Emilien-Wolff/Minuto/README.md

# Minuto - mission technique de l'ingénieur ⚙️
> [!NOTE]
> Un projet dans le cadre de ma première année en école d'ingénieur visant la fabrication d'un capteur d'irradiance solaire

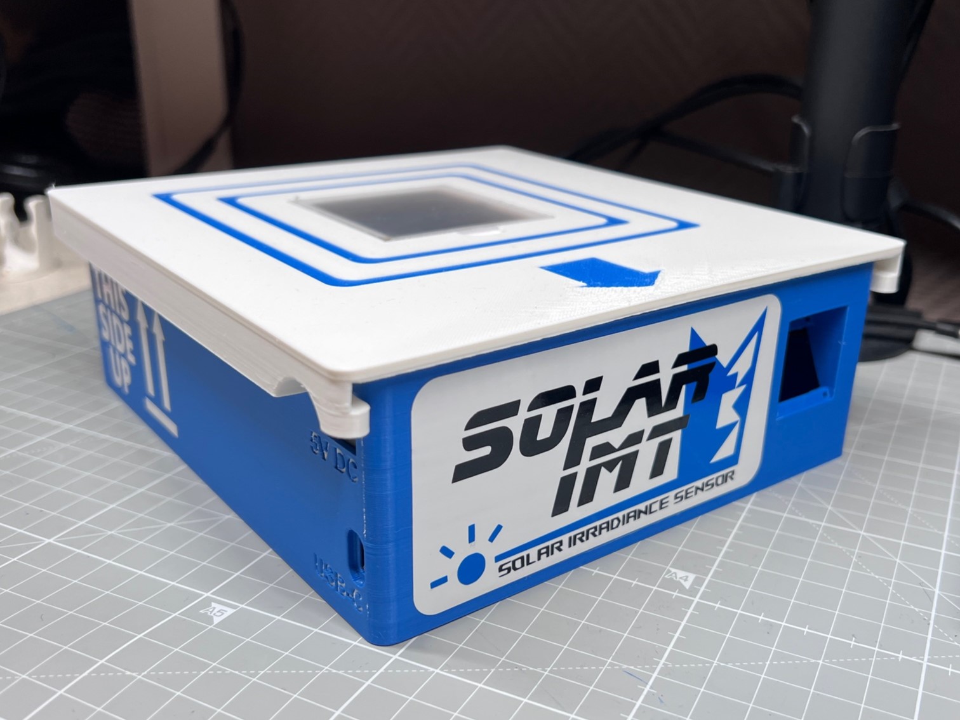
[picture p1: Photos/IMG_6275.JPG]


## Mon objectif

> Conceptualiser, dimensionner et créer un capteur fonctionnel d'irradiance solaire

## Points abordés

 - Gestion de projet : diagramme de Gantt, partage des tâches et planification
 - Étude des phénomènes conducto-convectifs et négligeabilité de ceux-ci
 - Montage en pont de Wheatstone amplifié sur thermistance
 - Étalonnage de cette dernière en enceinte adiabatique
 - Programmation du micro contrôleur Arduino R4
 - Apprentissage du pistage en CAO et fabrication sur mesure d’un PCB et d’un boîtier imprimé en 3D
 - Tests finaux et incertitudes

## FAQ

#### Pourquoi cette méthode de mesure ?
"Minuto" était une unité d'enseignement qui fait totalement partie de ma formation d'ingénieur et l'objectif était de faire un premier pas dans la gestion de projet. La mesure exploitant la capacité thermique massique du bloc de laiton était un moyen d'appliquer des montages électroniques de base et de discuter sur la précision de mesure. 

#### Combien de temps ça t'as pris ?

Le projet a duré 4 mois, d'octobre 2024 à janvier 2025

#### T'as fait ça tout seul ??

Pas du tout ! J'ai eu l'occasion de travailler avec des camarades de mon école, et ce fut extrêmement enrichissant de collaborer avec eux. Merci Anatole, Camille, Salah, Isma et LP !

## 🚀 Qui suis-je ?
Je suis actuellement en première année d'école d'ingénieur à l'école des Mines IMT Atlantique. Je voudrais continuer mon cursus dans l'électronique et les sytèmes embarqués
