Emilien-Wolff/Minuto/PCB/Readme.md

# PCB Minuto

Partie PCB du projet ! Ce dossier contient les fichiers nécessaires à la fabrication et à l'assemblage de la carte PCB du Minuto.

## Fichiers Inclus

- **Fichiers Gerber (.gbr) :** Utilisés pour la fabrication de la PCB. Envoyez-les à votre service de fabrication de PCB.
- **Liste des composants (BOM) (.csv) :** Liste complète des composants utilisés dans le design, avec les quantités et les numéros de pièces.
- **Schéma et Design PCB (.json) :** Métadonnées du design au format JSON, compatibles avec Easy EDA.
- **Faces du pcb (.pdf) :** deux faces de la PCB et schéma électrique global
- **Fichiers supplémentaires (.zip) :** Contient des modèles 3D, des informations sur les couches du PCB et des scripts de test.

## Licence

Ce projet est libre d'accès
