Emilien-Wolff/Minuto/Code_arduino/Readme.md

# Code - Capteur d'Irradiance Solaire  

Ce dossier contient :  
- **`tracé courbes.py`** : Script Python pour tracer les courbes d'étalonnage du capteur en relevant les couples **tension - température**. Il faut téléverser le fichier  **`etalonnage_final.ino`** dans l'Arduino avant.
- **`CapteurTempAvecEcranTempo_V7.ino`** : Code Arduino calculant et affichant l'irradiance solaire sur un écran **OLED 128x64** sur une durée **Δt** modifiable dans le code.  

## Utilisation  

- **Étalonnage (Python)** :  
  ```sh
  pip install matplotlib numpy  
  ```  
- **Mesure (Arduino)** :  
  1. Ouvrir `CapteurTempAvecEcranTempo_V7.ino` dans l'IDE Arduino.  
  2. Modifier $\Delta t$ si nécessaire.  
  3. Téléverser le code sur un **Arduino R4 Wifi**.  

📌 *Vérifiez les connexions du capteur et de l'afficheur OLED avant exécution. Attention aux faux contacts sur breadboard, c'est pour ça qu'on a décidé de faire un pcb ...*
