Emilien-Wolff/Minuto/Modele_3D/Readme.md

# Boîtier Minuto - Fichiers Fusion 360 & STEP

Ce dossier contient les fichiers de conception du boîtier Minuto, réalisés avec Fusion 360.

## Contenu du dossier

- **Fichiers `.f3z`** : Assemblages natifs de Fusion 360, permettant de modifier les composants individuellement.
- **Fichiers `.step`** : Modèles exportés en STEP, compatibles avec d'autres logiciels de CAO.

## Utilisation

- **Fusion 360** : Importez les fichiers `.f3z` pour modifier les composants du boîtier.
- **Autres logiciels CAO** : Utilisez les fichiers `.step` pour une compatibilité universelle.

📁 *Assurez-vous d'extraire tous les fichiers associés avant d'ouvrir un assemblage dans Fusion 360.*

---

Impression 3D en PLA sur P1S, 0,2mm d'épaisseur de couche, avec supports, attention à bien choisir la couleur du couvercle supérieur
