Emilien-Wolff/Minuto/Quatre_quadrants/Suivi_GroupeB11_05nov.pdf

# Reporting Quatre Quadrants n°3

## Projet Minuto - FISE A1

## Groupe B11

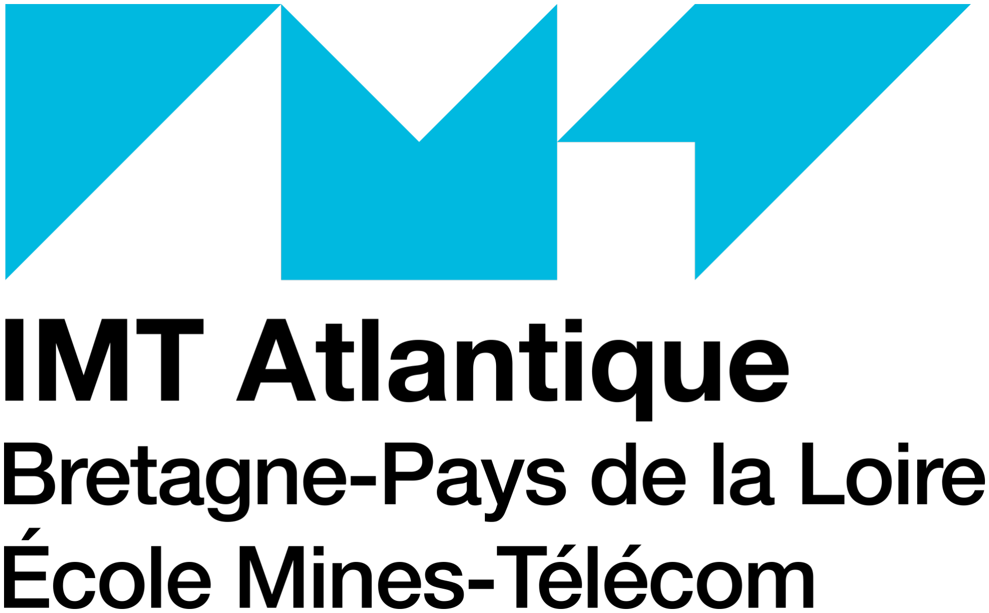
[picture p2: figure]

5 novembre 2024

Minuto - IMT Atlantique

Consitution de l’équipe
Groupe/Equipe : B11
Chef de projet : Emilien WOLFF

Actualisation de la fiche à la date du : 05/11

▷ Ce que nous avions prévu de faire aujourd’hui

- Mesure de cT à l’aide de la relation :

claiton =

E

mlaiton × ∆T

=

(V × I) × ∆t

mlaiton × (Tf − Ti)
- Suivi du projet dans GanttProject
- Continuer le compte-rendu final sur Overleaf
- Etalonnage du ´ | pont de Wheatstone
- Quantifier les échanges conducto-convectifs non pris en compte dans la relation

Firrad =

m · cT · ∆T
∆t · S
- Comparaison de la précision du pont de Wheatstone et du montage avec le pont diviseur de tension
- Bonus : Utilisation d’un afficheur OLED pour avoir la température en temps réel et actualisation de l’affichage

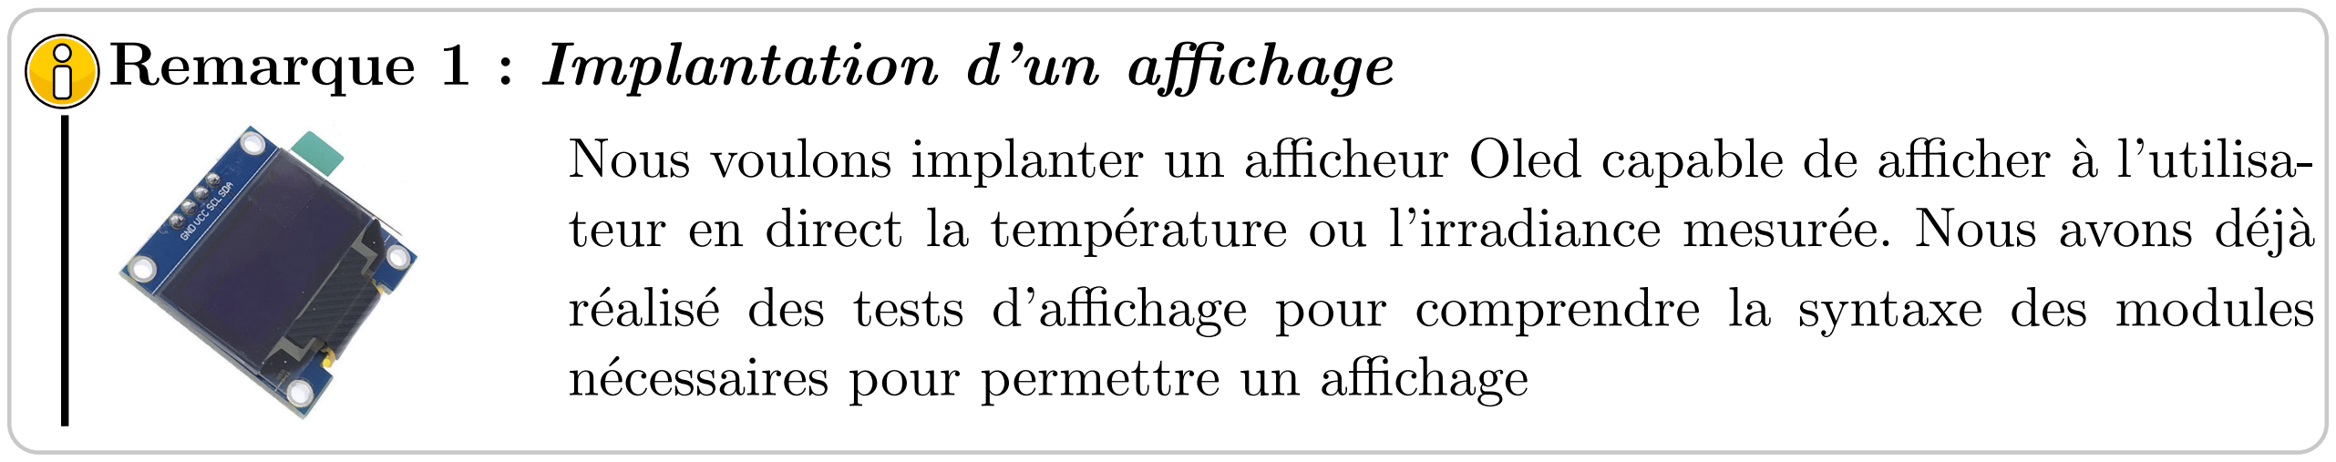
[picture p3: figure]
nécessaires pour permettre un affichage

Nous voulons implanter un afficheur Oled capable de afficher à l’utilisa-teur en direct la température ou l’irradiance mesurée. Nous avons déjà réalisé des tests d’affichage pour comprendre la syntaxe des modules

Remarque 1 : Implantation d’un affichage

▷ Ce que nous avons réalisé effectivement

- Etalonnage du ´ | pont de Wheatstone
- Suivi du projet dans GanttProject
- Continuer le compte-rendu final sur Overleaf
- Pour mesurer la capacité calorifique cT nous avons :

— Mesuré l’intensité i à l’aide de la loi d’Ohm : I = 510mA
— Mesuré la masse m de laiton : m = 622g
— Choisi un ∆t = 600 s pendant lesquelles nous avons mesuré un ∆T = 3,77 K
- On trouve finalement : cT = 646 J·K⁻¹
- kg⁻¹

▷ Ce que nous prévoyons de faire les prochains jours

- Refaire la mesure de cT en réduisant la longueur du fil
- Implémentation de l’affichage OLED
- Calcul de la capacité thermique massique avec la nouvelle longueur de fil
- Modélisation d’un boitier pour intégrer le LCD et impression
- Première campagne de mesure

1

Minuto - IMT Atlantique

▷ Problèmes rencontrés et solutions mises en œuvre

- Fil NICr vert trop long pour entrer entièrement dans la cavité de laiton. Nous prévoyons donc de réduire la longeur du fil pour résoudre ce problème
- Pour la première version du code en annexe, l’alimentation du DDT était de 3,3V et pas de 5V. Les valeurs étaient abérantes.

## Annexes : codes de la session

Mesure de la capacité cT à partir des coefficients de la courbe de la session précédente (coeff directeur et ordonnées à l’origine)

1 | // P a r a m t r e s du diviseur de tension
2 | const int analogPin = A0; | // Broche analogique pour lire la tension
3 | const float Vcc = 3.3; | // Tension d’ alimentation du diviseur de
| tension (par exemple 5V)

4
5 | // Coefficients du m o d l e | l i n a i r e
6 | const float a = -0.0188219999851621; | // Coefficient de la pente
7 | const float b = 1.5478256877795376; | // Coefficient de l’ o r d o n n e | l
| ’origine

8
9 | void setup () {
10 | Serial . begin (115200) ; | // Initialisation de la communication s r i e
11 | }

12
13 | void loop () {
14 | int adcValue = analogRead ( analogPin ) ; | // Lecture de la tension
| analogique
15 | float U = ( adcValue / 1023.0) * Vcc; | // Conversion de la
| lecture ADC en tension

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

19
20 | // Affichage des r s u l t a t s dans le moniteur s r i e
21 | Serial . print (" Tension (V): ") ;
22 | Serial . print (U) ;
23 | Serial . print (" | T e m p r a t u r e ( C ): ") ;
24 | Serial . println ( temperature ) ;

25
26 | delay (1000) ; | // Attente avant la prochaine mesure
27 | }

Remarques : Le code fonctionne correctement et mesure de températures sont bonnes

2
