Emilien-Wolff/Minuto/Quatre_quadrants/Suivi_GroupeB11_12nov.pdf

# Reporting Quatre Quadrants n°4

# Projet Minuto - FISE A1

## Groupe B11


## 12 novembre 2024

### Minuto - IMT Atlantique

### Consitution de l’équipe Groupe/Equipe : B11 Chef de projet : Emilien WOLFF

### Actualisation de la fiche à la date du : 12/11

## ▷ Ce que nous avions prévu de faire aujourd’hui

### - Mesure de cT à l’aide de la relation :

claiton =

E

mlaiton × ∆T

=

### (V × I) × ∆t

mlaiton × (Tf − Ti)

### Or on remarque que :

∆T
∆t

=

P

### mct

Ce rapport est donc constant et nous allons donc réaliser plusieurs mesures de températures sur des intervalles ∆t = 30 s puis réaliser une régression linéaire.

### - Suivi du projet dans GanttProject

### - Continuer le compte-rendu final sur Overleaf

- Etalonnage du ´ | pont de Wheatstone

### - Quantifier les échanges conducto-convectifs non pris en compte dans la relation

Firrad =

### m · cT · ∆T

∆t · S

### - Comparaison de la précision du pont de Wheatstone et du montage avec le pont diviseur

### de tension - Découpage et détorsadage du fil de NiCr pour qu’il ait les bonnes dimensions et pour

### garder uniquement le fil blanc chauffant

## ▷ Ce que nous avons réalisé effectivement

### - Modélisation du boîtier en 3D à l’aide du logiciel Fusion 360

- Test d’affichage des valeurs de la température et de l’irradiance sur l’écran OLED.

### - Prise de mesures du boîtier

- Découpage et détorsadage du fil de NICr pour qu’il ait les bonnes dimensions de manière

### à garder uniquement le fil blanc chauffant - Pour mesurer la capacité calorifique cT nous avons :

### — Choisi un ∆t = 30 s pendant lesquelles nous avons mesuré un ∆T. Nous avons réalisé cela pendant 11 minutes. Voici le tableau des premières valeurs :

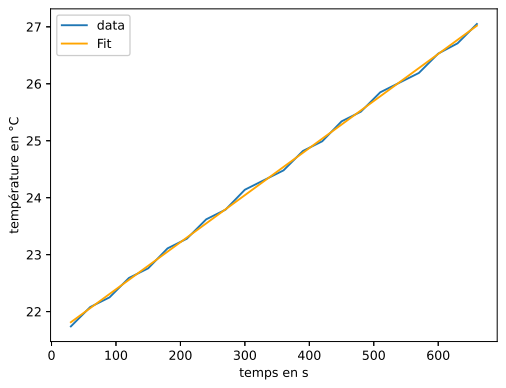
[picture p4: figure]

### Régression linéaire sur les valeurs mesurées

Temps (s) | Température (°C)
0 | 21.91
30 | 21.74
60 | 22.08
90 | 22.25
120 | 22.59
150 | 22.76
180 | 23.11
210 | 23.28
660 | 27.05

### — Mesuré l’intensité i à l’aide de la loi d’Ohm : I = 510mA

### — Mesuré la masse m de laiton : m = 622g

### - On trouve finalement :

## cT = 423 J·K⁻¹

# - kg⁻¹

### - Suivi du projet dans GanttProject

### - Continuer le compte-rendu final sur Overleaf

### - Modélisation 3D du boîtier

## ▷ Ce que nous prévoyons de faire les prochains jours

- Modification des côtes du boîtier et impression 3D (attention à ne pas choisir des couleurs

### sombres)

### - Deuxième campagne de mesures

## ▷ Problèmes rencontrés et solutions mises en œuvre

### - Essai infructueux du pont de Wheatstone (mauvais branchements que nous allons re-

### prendre dans la semaine)

# Annexes : codes de la session

## Code final comprenant l’affichage sur le LCD

1
2 | # include < SPI .h >
3 | # include < Wire .h >
4 | # include < Adafruit_GFX .h > | // for the rectangle draw and text display
5 | # include < Adafruit_SSD1306 .h > | // to control the OLED chip

6

7
8 | int measurement_counter = 0; | // count the number of measurements done ; used for
Serial print

9
10 | // /////////////////////////
11 | // | SCREEN DESCRIPTION
12 | // | _________________
13 | // | | _________________ | | Area YELLOW 128 x 16 pixels (0 to 15)
14 | // | | | |
15 | // | | | | | Area BLUE 128 x 48 (16 to 63)
16 | // | | | |
17 | // | | _________________ |

18
19 | # define SCREEN_WIDTH 128 // OLED display width , in pixels
20 | # define SCREEN_HEIGHT 64 // OLED display height , in pixels
21 | # define SCREEN_BLUE_START 16 // OLED blue area starts here in Y position
22 | // Declaration for an SSD1306 display connected to I2C (SDA , SCL pins )
23 | # define OLED_RESET | -1 // Reset pin # (or -1 if sharing Arduino reset pin).
No reset on the screen module .
24 # define SCREEN_ADDRESS 0 x3C // The address written on the OLED board (0 x78) must be divided by 2 = > 0 x3C

25
26 | // Create the display object connected to I2C bus ( Wire )
27 | Adafruit_SSD1306 display ( SCREEN_WIDTH , SCREEN_HEIGHT , &Wire , OLED_RESET ) ;

29 // //////////////////////////

30
31 | // | FUNCTIONS | //

32
33 // //////////////////////////

34
35 | // ///////////////////////////////////
36 | // | Function : draws a horizontal bar filled for the value given , in proportion
to the max_value given
37 | // | Input : an integer for the value and an integer for the max value ( bar
totally filled ). Negative value not supported
38 | // | Output : none
39 | // ///////////////////////////////////
40 | void draw_value_in_bar ( unsigned long value , unsigned long max_value )
41 | {
42 | if (value > max_value ) value = max_value ; | // avoid to try to draw an
impossible bar.
43 | display . fillRect (0 , 0 , display . width () , SCREEN_BLUE_START -1 , SSD1306_BLACK ) ;
// Draw black rectangle = erase the bar display area
44 | display . drawRect (0 , 0 , display . width () , SCREEN_BLUE_START -1 , SSD1306_WHITE ) ;
// Draw the frame for the full bar ( empty fill )
45 | display . fillRect (0 , 0 , (int ) display . width () * value / max_value ,
SCREEN_BLUE_START -1 , SSD1306_WHITE ) ; // Draw the necessary fill corresponding to the value
46 | display . display () ; | // push to the display
47 | }

48
49 | // ///////////////////////////////////
50 | // | Function : displays a string centered vertically and horizontally in the blue
part of the screen
51 | // | Input : a text in the STRING type
52 | // | Output : none
53 | // ///////////////////////////////////
54 | void draw_string_centered ( String text )
55 | {
56 | Serial . print (" Measurement ") ;
57 | Serial . print ( measurement_counter ) ;
58 | Serial . print (" : ") ;
59 | Serial . println ( text ) ;

60
61 | // Text dimensions calculation
62 | int16_t x1 , y1;
63 | uint16_t textWidth , textHeight ;
64 | display . setTextSize (3) ; | // Normal : 1 | Use 3X normal
size
65 | display . setTextColor ( SSD1306_WHITE ) ; | // Draw white text

66
67 | display . getTextBounds (text , 0 , 16 , &x1 , &y1 , & textWidth , & textHeight ) ;
68 | // Erase the display area with black rectangle
69 | display . fillRect (0 , 16 , display . width () , display . height () , SSD1306_BLACK ) ;
70 | // compute the text cursor position to get it centered
71 | int16_t xPos = ( display . width () - textWidth ) / 2;
72 | int16_t yPos = ( (( display . height () - SCREEN_BLUE_START - textHeight ) / 2) +
SCREEN_BLUE_START ) ;
73 | display . setCursor (xPos , yPos ) ;
74 | display . print ( text ) ;
75 | display . display () ;
76 | }

77
78 | // ADC characteristics
79 | # define MAX_VOLTAGE_ADC 4.6 | // the real voltage used by the ADC on the arduino
board
80 | # define ADC_STEPS 1024 | // Number of steps of the conversion : 10 bits
81 | // Declaration of the coefficient for the function approaching the thermistance
voltage with resistive voltage divider
82 # define THERM_DIV_COEFF_A0 1 // for constant part

83 | # define THERM_DIV_COEFF_A1 1 // for linear part
84 | # define THERM_DIV_COEFF_A2 1 // for square part
85 | # define THERM_DIV_COEFF_A3 1 // for cubic part

86
87 | // ///////////////////////////////////
88 | // | Function : gives the temperature corresponding the the ADC value , using the
thermistance curve
89 | // | Input : the ADC value , and int
90 | // | Output : the temperature as a float
91 | // ///////////////////////////////////
92 | float calculate_temperature (int adc_value )
93 | {
94 | float voltage , temperature ;
95 | voltage = MAX_VOLTAGE_ADC * adc_value / ADC_STEPS ;
96 | temperature = THERM_DIV_COEFF_A0 + THERM_DIV_COEFF_A1 * voltage +
THERM_DIV_COEFF_A2 *pow( voltage ,2) + THERM_DIV_COEFF_A3 *pow( voltage ,3) ;
97 | | return ( temperature ) ;
98 | }

99
100 | # define BLOC_MASSE | 0.5 // mass in SI
101 | # define BLOC_CAPA 300 | // thermal capacity in SI
102 | # define BLOC_SURFACE 0.05*0.05 | // Surface of the black face in SI
103 | // ///////////////////////////////////
104 | // | Function : calculates the irradiance
105 | // | Input : the current temperature of the bloc and the current time
106 | // | Output : irradiance as an INT
107 | // ///////////////////////////////////
108 | float previous_temp ; | // the previous temperature measured
109 | unsigned long previous_time ; | // the value is in millisecond
110 | int calculate_irradiance ( float temp_now , unsigned long time_now )
111 | {
112 | | float irrad ;
113 | irrad = BLOC_MASSE * BLOC_CAPA * abs( temp_now - previous_temp ) /
BLOC_SURFACE / ( time_now - previous_time ) * 1000;
114 | | return (( int ) irrad ) ; | // round to integer value , precision of the system is
| | more than 5%
115 | }

116

117
118 // //////////////////////////

119
120 | // | SETUP | //

121
122 // //////////////////////////

123
124 | float current_temp ;
125 | unsigned long current_time ;
126 | int analogPin = A0; | // the pin where the voltage value must be read
127 | unsigned long measurement_start_time = 0; | // Time at which the measurement has
started
128 | int irradiance =0;
129 | int measurement_duration = 10000; | // initial value set to 10 sec to have
enough Delta T. This could be changed by the program to adjust if deltaT is
| | not enough

130

131
132 | void setup () {
133 | | Serial . begin (115200) ;

134
135 | | // SSD1306 OLED init
136 | if (! display . begin ( SSD1306_SWITCHCAPVCC , SCREEN_ADDRESS ) ) {
137 | Serial . println (F(" SSD1306 allocation failed ") ) ;
138 | for (;;) ; // Don ’t proceed , loop forever
139 | }
140 | // Clear the display buffer and updates the screen ( full clear )
141 | | display . clearDisplay () ;

142 | | display . display () ;

143
144 | previous_temp = calculate_temperature ( analogRead ( analogPin ) ) ; | // initialize
the value to the current temperature
145 | previous_time = millis () ; | // initialize time value
146 | | Serial . println ("") ;
147 | Serial . print (" Measurement interval set to : ") ;
148 | Serial . print ( measurement_duration /1000.0) ;
149 | | Serial . println (" sec ") ;
150 | }

151
152 | # define MAX_SUN_IRRADIANCE 1200 // value max expected , can be used to avoid
| | abnormal displays
153 | # define MIN_TEMP_VARIATION 0.0001 // Minimum of variation to have a trustable
irradiance calculation . 0.01 is normal variation in 1s with 1000 W/m2
154 | # define DELAY_BETWEEN_SCREEN_UPDATE 100 | // in milliseconds

155

156

157
158 // //////////////////////////

159
160 | // | LOOP | //

161
162 | // //////////////////////////
163 | void loop ()
164 | {
165 | delay ( DELAY_BETWEEN_SCREEN_UPDATE ) ; | // make a pause to have enough time
between two measurements for temperature to change

166
167 | | // update the time bar
168 | | current_time = millis () ;
169 | draw_value_in_bar ( current_time - previous_time , measurement_duration ) ; | //
draw the bar , max is set to the total measurement time

170
171 | if ( current_time - previous_time > measurement_duration ) | // now the
interval is reached , do the measurement and calculation and display
172 | {
173 | | // get values
174 | current_temp = calculate_temperature (( int) random (1024) ) ; | // fake value
for test without hardware
175 | // current_temp = calculate_temperature ( analogRead ( analogPin )); | // Real
| | value measured
176 | current_time = millis () ;
177 | measurement_counter += 1;
178 | // calculate the irrandiance
179 | irradiance = calculate_irradiance ( current_temp , current_time ) ;

180
181 | | // Display on screen
182 | if ( irradiance < MAX_SUN_IRRADIANCE )
183 | {
184 | draw_string_centered ( String ( irradiance ) ) ; | // Display the
value below the time bar
185 | }
186 | else
187 | {
188 | draw_string_centered (" ERROR ") ; | // Value abnormal
189 | }

190

191
192 | // store for next delta T and delta t calculation
193 | previous_temp = current_temp ;
194 | previous_time = current_time ;
195 | }
196 | }

### Remarques : Le code fonctionne correctement et mesure de températures sont bonnes
