Emilien-Wolff/Minuto/Quatre_quadrants/Suivi_GroupeB11_15oct.pdf

# Reporting Quatre Quadrants n°1

# Projet Minuto - FISE A1

## Groupe B11


## 15 octobre 2024

### Minuto - IMT Atlantique

### Consitution de l’équipe Groupe/Equipe : B11 Chef de projet : Emilien WOLFF

### Actualisation de la fiche à la date du : 15/10

## ▷ Ce que nous avions prévu de faire aujourd’hui

- Réalisation des deux montages pour la mesure de température à partir de la thermistance :

### diviseur de tension et pont de Wheatstone

- Réalisation du montage pour la mesure de température absolue à partir du capteur TMP117

### - Code pour l’étalonnage de la température de la thermistance et tracés des courbes

### - Montage sur breadboard et étude de la compacité

### - Mise au propre des tâches dans GanttProject et définition des liens entre les tâches

- Recherche des coefficients de la courbe de la thermistance (coefficients de Steinhart-Hart)

### - Détermination de la résistance de la thermistance Rth

### - Soudure des fils (pont diviseur de tension entier)

## ▷ Ce que nous avons réalisé effectivement

### - Réalisation du diviseur de tension et branchement du TMP117 sur la même carte. Essai

de mesure de l’écart de température entre les deux capteurs, et essais de tracés de courbe

### - Soudure des fils (pont diviseur de tension entier) au propre et mise en place de gaines

### thermo pour éviter les court-circuits - Mise au propre des tâches dans GanttProject et définition des liens entre les tâches

## ▷ Ce que nous prévoyons de faire les prochains jours

### - Etalonnage de la thermistance (prochaine séance de minuto)

- A partir des besoins pour la mesure finale, établissement de la structure finale du boitier.

### - Tester les différentes parties de code indépendamment

## ▷ Problèmes rencontrés et solutions mises en oeuvre

- Changement des fils défectueux et ajout de fils supplémentaires pour ne pas que le problème

### réapparaisse

- Léger écart entre la température mesurée et la température supposée de la pièce → à

### quantifier !

- Problèmes rencontrés sur le test final avec toutes les composantes → test des différentes

### parties du code indépendamment

Montage non transportable, nécessité de transportabilité → utilisation de la mémoire de l’Arduino, donc modification du code dans le futur.

## Attention : Besoin de transportabilité à satisfaire

# Annexes : codes de la session

## Test diviseur de tension

1 | // D f i n i r les broches
2 | const int pinThermistor = A0; | // E n t r e analogique pour lire la tension
3 | const float Vcc = 3.3; | // Tension d’ alimentation (3.3 V dans ton montage )
4 | const float R = 10000; | // R s i s t a n c e en s r i e (10 k | )

5
6 | // C a r a c t r i s t i q u e s de la thermistance
7 | const float R0 = 10000; | // R s i s t a n c e de la thermistance | 25 C | (10 k
| )
8 | const float T0 = 298.15; | // T e m p r a t u r e de r f r e n c e en Kelvin (25 C | =
| 298.15 K)
9 | const float B = 3950; | // Constante B de la thermistance

10
11 | void setup () {
12 | Serial . begin (9600) ; | // Initialiser la communication s r i e
13 | }

14
15 | void loop () {
16 | int valeurBrute = analogRead ( pinThermistor ) ; | // Lire la tension (0 | 1023)
17 | float Vmes = ( valeurBrute / 1023.0) * Vcc; | // Convertir en tension r e l l e

18
19 | // Calcul de la r s i s t a n c e de la thermistance ( Rth)
20 | float Rth = (R * Vmes ) / (Vcc - Vmes ) ;

21
22 | // Utilisation de l’ | quation | de Steinhart - Hart pour convertir en t e m p r a t u r e
23 | float inv_T = (1/ T0) + (1/B) * log(Rth / R0) ;
24 | float temperature = (1 / inv_T ) - 273.15; | // Conversion en | C

25
26 | // Afficher la t e m p r a t u r e et la tension
27 | Serial . print (" Tension Vmes : ") ;
28 | Serial . print ( Vmes ) ;
29 | Serial . print (" V, T e m p r a t u r e : ") ;
30 | Serial . print ( temperature ) ;
31 | Serial . println (" | C ") ;

32
33 | delay (1000) ; | // Attendre 1 seconde avant la prochaine lecture
34 | }

Le code est fonctionnel et on récupère des couples (Vmes et T).

## Code pour l’étalonnage et la prise de mesure simulltanée des deux capteurs

1 | # include < Wire .h >
2 | # include < SparkFun_TMP117 .h > | // B i b l i o t h q u e SparkFun TMP117

3
4 | // Constantes pour la thermistance
5 | const int thermistorPin = A0; | // Broche analogique pour le pont diviseur de
| tension
6 | const float Rref = 10000.0; | // R s i s t a n c e de r f r e n c e de 10k ohms
7 | const float Vcc = 5.0; | // Tension d’ alimentation de l’Arduino (5V)

8
9 | // Coefficients de Steinhart - Hart pour la thermistance ( ajustez selon votre
| thermistance )
10 | const float A = 0.001129148;
11 | const float B = 0.000234125;
12 | const float C = 0.0000000876741;

13
14 | // Capteur TMP117 ( SparkFun )
15 | TMP117 tmp117 ;

16
17 void setup () {

18 Serial . begin (115200) ;

19
20 | // Initialisation du capteur TMP117 SparkFun
21 | if ( tmp117 . begin () == false ) {
22 | Serial . println (" Erreur : Impossible de d t e c t e r le capteur TMP117 SparkFun
!") ;
23 | while (1) ;
24 | }

25
26 | Serial . println (" Capteur TMP117 SparkFun p r t .") ;
27 | }

28
29 | void loop () {
30 | // --- Lecture du capteur TMP117 SparkFun ---
31 | float tmp117Temperature = tmp117 . readTempC () ; | // Lecture de la t e m p r a t u r e
en d e g r s Celsius

32
33 | // --- Lecture de la thermistance en diviseur de tension ---
34 | int adcValue = analogRead ( thermistorPin ) ; | // Lecture de la valeur analogique
35 | float Vout = ( adcValue * Vcc) / 16384.0; | // Conversion en tension
36 | float Rth = Rref * (Vcc / Vout - 1.0) ; | // Calcul de la r s i s t a n c e de la
thermistance

37
38 | // --- Calcul de la t e m p r a t u r e de la thermistance avec Steinhart - Hart ---
39 | float lnRth = log(Rth) ;
40 | float tempK = 1.0 / (A + B * lnRth + C * pow(lnRth , 3) ) ; | // T e m p r a t u r e en
Kelvin
41 | float thermistorTempC = tempK - 273.15; | // Conversion en d e g r s Celsius

42
43 | // --- Affichage des r s u l t a t s ---
44 | Serial . print (" T e m p r a t u r e TMP117 : ") ;
45 | Serial . print ( tmp117Temperature ) ;
46 | Serial . print (" | C , ") ;

47
48 | Serial . print (" T e m p r a t u r e thermistance : ") ;
49 | Serial . print ( thermistorTempC ) ;
50 | Serial . println (" | C ") ;

51
52 | // --- | talonnage | ---
53 | float calibrationOffset = tmp117Temperature - thermistorTempC ;
54 | Serial . print (" D c a l a g e pour | talonnage | ( Offset ) : ") ;
55 | Serial . print ( calibrationOffset ) ;
56 | Serial . println (" | C ") ;

57
58 | delay (1000) ; | // Pause d’une seconde avant la prochaine lecture
59 | }

### Après passage d’un encadrant on a modifié le code pour :

### 1. Récupérer toutes les secondes un couple tension (diviseur de tension) / température (TMP117)

### 2. Enregistrer ces couples dans un tableau sur la mémoire locale de l’Arduino

### 3. Exporter ce tableau et tracer la courbe correspondante dans Python
