Emilien-Wolff/Minuto/Quatre_quadrants/Readme.md

# Dossier des Rapports 4 Quadrants

Ce dossier contient les rapports correspondant aux 4 quadrants du groupe de travail B11
