Emilien-Wolff/Minuto/Quatre_quadrants/Suivi_GroupeB11_03dec.pdf

# Reporting Quatre Quadrants n°5

# Projet Minuto - FISE A1

## Groupe B11


## 3 décembre 2024

### Minuto - IMT Atlantique

### Constitution de l’équipe Groupe/Equipe : B11 Chef de projet : Emilien WOLFF

### Actualisation de la fiche à la date du : 03/12

## ▷ Ce que nous avions prévu de faire aujourd’hui

### - Dernière mesure de cT à l’aide de la relation :

claiton =

E

mlaiton × ∆T

=

### (V × I) × ∆t

mlaiton × (Tf − Ti)

### Or on remarque que :

∆T
∆t

=

P

### mct

Ce rapport est donc constant et nous allons donc réaliser plusieurs mesures de températures sur des intervalles ∆t = 30 s puis réaliser une régression linéaire.

### - Calcul des incertitudes associées

### u(cT )

cT

=

s
u(V )
V

2
+
u(I)
I

2
+
u(∆T)
∆T

2
+
u(m)
m

2
+
u(∆t)
∆t

2

### - Suivi du projet dans GanttProject

### - Continuer le compte-rendu final sur Overleaf

### - Calcul des incertitudes de la mesure expérimentale de CT

### - Ecriture d’un protocole précis pour les mesures d’irradiance ´

### - Feuille Python pour faire des tirages de Monte Carlo

## ▷ Ce que nous avons réalisé effectivement

### - Calcul de l’incertitude associée à la mesure de cT :

### u(cT )

cT

= 0, 02 = 2%

On trouve une incertitude très acceptable, à partir de celles des instruments de mesure :

u(V )
V

= 0, 01

u(I)
I
= 0, 01 | u(∆t) = 0, 5s | u(m) = 1g | u(∆T) = 0, 05◦C

### - On faire alors une simulation de Monte Carlo

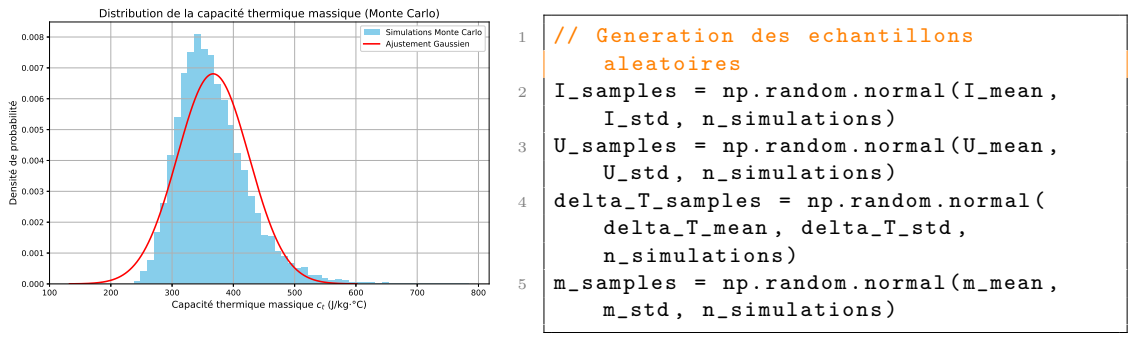
[picture p6: figure]
// Generation des echantillons; aleatoires; I_std , n_simulations ); U_std , n_simulations ); delta_T_mean , delta_T_std , n_simulations ); m_std , n_simulations )

### Simulation de Monte Carlo sur Python

2 | I_samples = np. random . normal (I_mean ,
3 | U_samples = np. random . normal (U_mean ,
4 | delta_T_samples = np. random . normal (
5 | m_samples = np. random . normal (m_mean ,

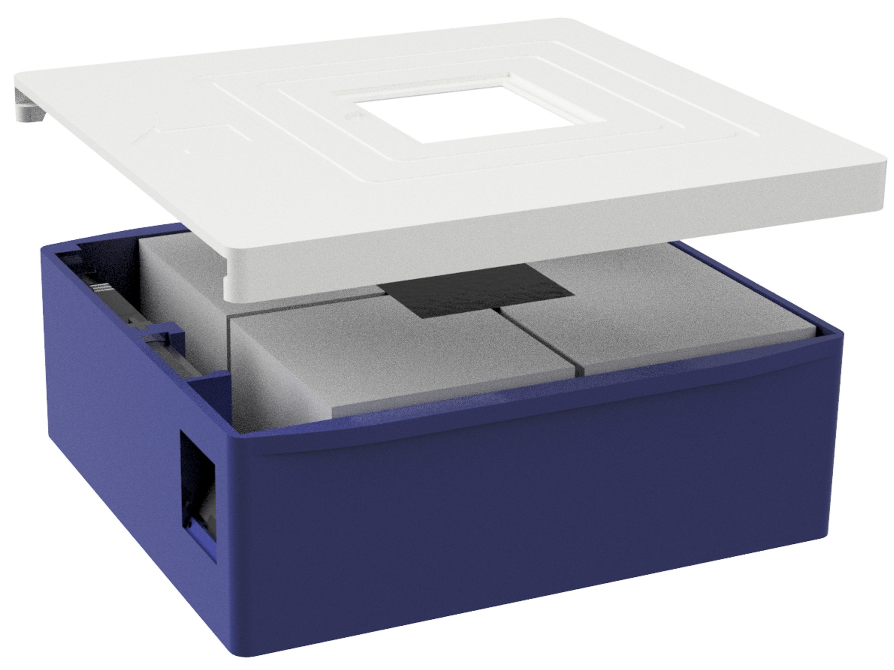
[picture p7: figure]

Figure 1 – Notre boitier, intégrant le polystyrène, l’électronique et le bloc de laiton

## ▷ Ce que nous prévoyons de faire les prochains jours

### - Test de notre boîtier quand il y aura du soleil (bientôt ?)

## ▷ Problèmes rencontrés et solutions mises en œuvre

- Valeurs incohérentes affichées sur l’afficheur OLED, code à revoir ...

# Annexes : codes de la session

## Code pour le tirage de Monte Carlo

1
2 | import numpy as np
3 | import matplotlib . pyplot as plt

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

8
9 | U_mean = 4.955 | # Tension moyenne (V)
10 | U_std = 0.04955 | # Incertitude sur la tension (V)

11
12 | delta_T_mean = 22.59 -22.25 | # Variation de t e m p r a t u r e moyenne ( C )
13 | delta_T_std = 0.05 | # Incertitude sur la variation de t e m p r a t u r e ( C )

14
15 | m_mean = 0.622 | # Masse moyenne (kg)
16 | m_std = 0.001 | # Incertitude sur la masse (kg)

17
18 | delta_t = 30 | # D u r e de l’ e x p r i e n c e (s) , s u p p o s e sans incertitude

19
20 | // Nombre de simulations Monte Carlo
21 | n_simulations = 10000

22
23 | // G n r a t i o n des | chantillons | a l a t o i r e s
24 | I_samples = np. random . normal (I_mean , I_std , n_simulations )
25 | U_samples = np. random . normal (U_mean , U_std , n_simulations )
26 | delta_T_samples = np. random . normal ( delta_T_mean , delta_T_std , n_simulations )
27 | m_samples = np. random . normal (m_mean , m_std , n_simulations )

28
29 | // Calcul de la c a p a c i t | thermique massique pour chaque simulation
30 | ct_samples = ( U_samples * I_samples * delta_t ) / ( m_samples * delta_T_samples )

31
32 | // Calcul des statistiques
33 | ct_mean = np. mean ( ct_samples )
34 | ct_std = np. std( ct_samples )

35
36 | // T r a c | de la distribution
37 | plt. figure ( figsize =(10 , 6) )
38 | plt. hist ( ct_samples , bins =50 , density =True , alpha =0.6 , color =’skyblue ’, label =’
Simulations Monte Carlo ’)

39
40 | // T r a c | de la gaussienne a j u s t e
41 | x = np. linspace ( ct_mean - 4* ct_std , ct_mean + 4* ct_std , 500)
42 | gaussian = (1 / ( ct_std * np. sqrt (2 * np.pi) ) ) * np.exp ( -0.5 * ((x - ct_mean ) /
ct_std ) **2)
43 plt. plot (x, gaussian , color =’red ’, linewidth =2 , label =’Ajustement Gaussien ’)

44
45 | // Titres et l g e n d e s
46 | plt. title (" Distribution de la c a p a c i t | thermique massique ( Monte Carlo )",
fontsize =14)
47 | plt. xlabel (" C a p a c i t | thermique massique $c_t$ (J/ k g | C )", fontsize =12)
48 | plt. ylabel (" D e n s i t | de p r o b a b i l i t ", fontsize =12)
49 | plt. legend ()
50 | plt. grid ()
51 | plt. show ()

52
53 | // Affichage des r s u l t a t s
54 | print (f" C a p a c i t | thermique massique moyenne : { ct_mean :.2f} J/( k g | C )")
55 | print (f" Incertitude ( cart - type ): { ct_std :.2f} J/( k g | C )")

### Remarques : Le code fonctionne correctement et mesure de températures sont bonnes
