Emilien-Wolff/Minuto/Courbes/Courbe tracé température tension V2.png

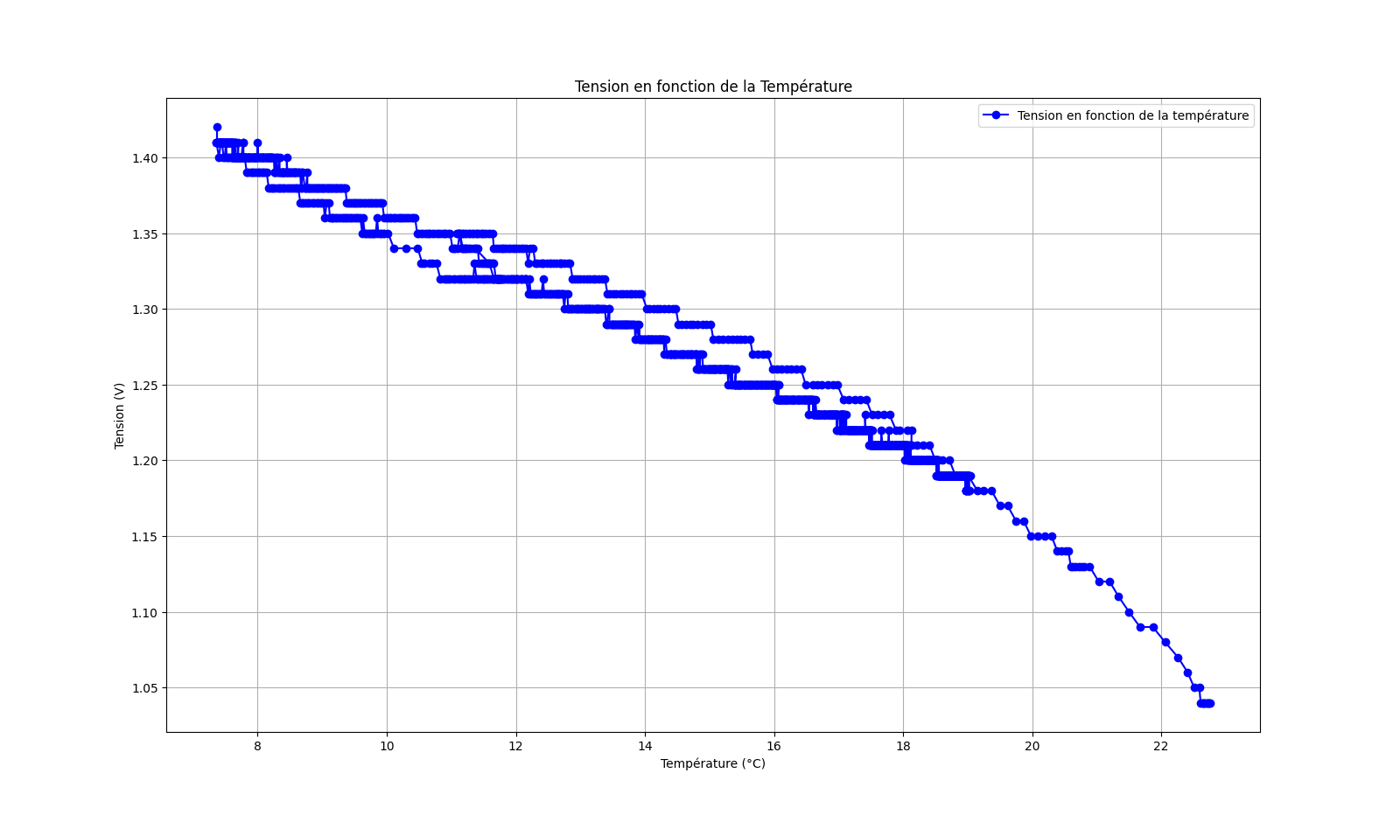
Courbes/Courbe tracé température tension V2.png
