Emilien-Wolff/Minuto/Courbes/Salve 2.png

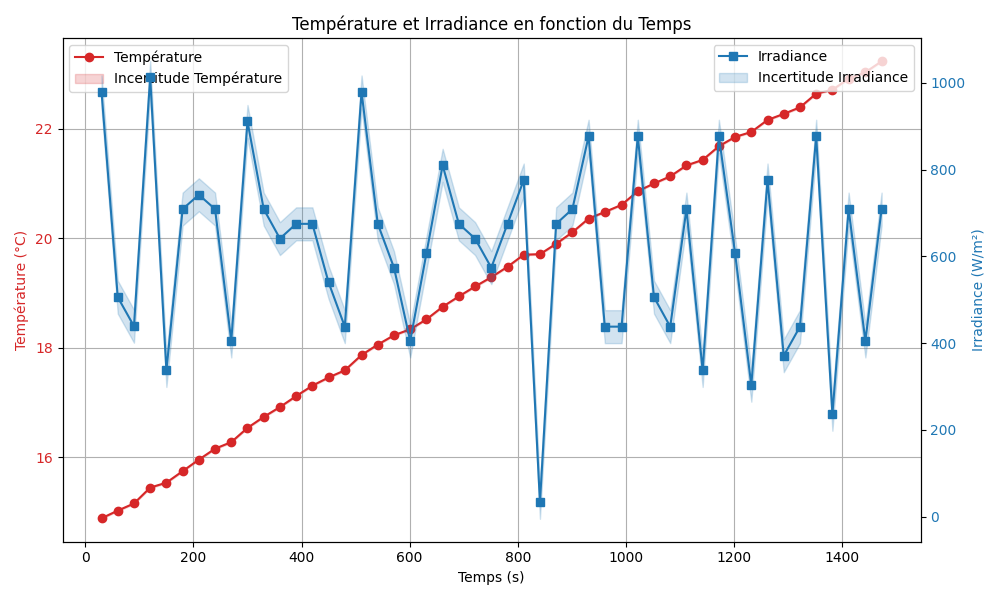
Courbes/Salve 2.png
