Emilien-Wolff/Minuto/Photos/75373098756__DFC0BEF7-0056-48CD-A131-06DE7995131F.JPG

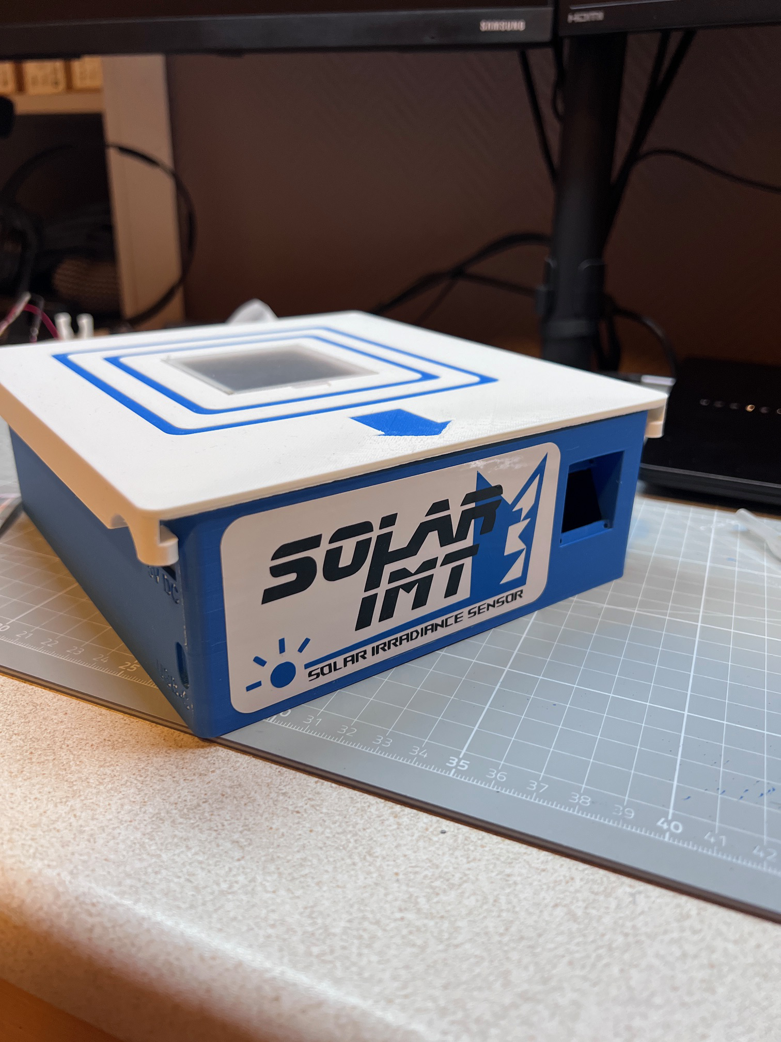
Photos/75373098756__DFC0BEF7-0056-48CD-A131-06DE7995131F.JPG
