Emilien-Wolff/Minuto/Photos/IMG_0797.jpg

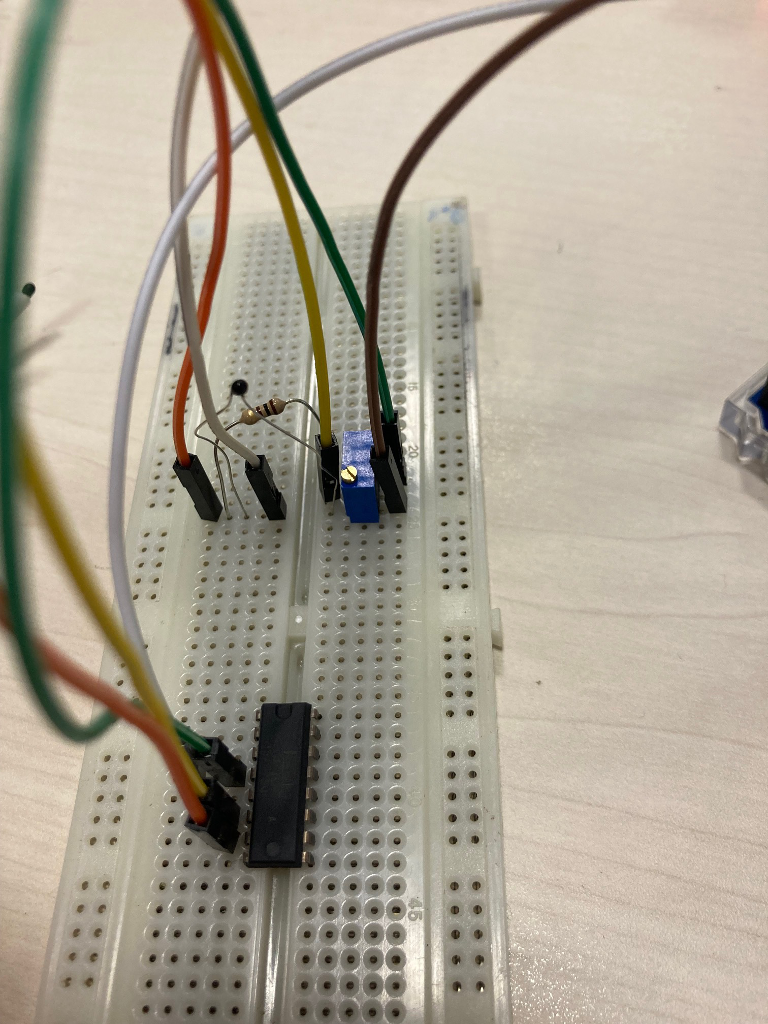
Photos/IMG_0797.jpg
