Emilien-Wolff/Minuto/Photos/IMG_5778.JPG

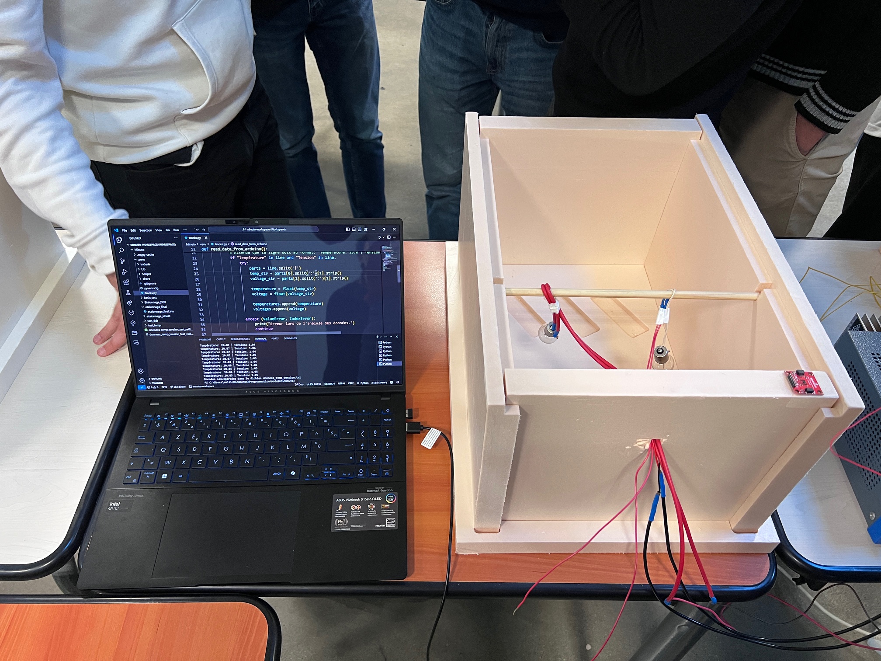
Photos/IMG_5778.JPG
