Emilien-Wolff/Minuto/Photos/IMG_5781.JPG

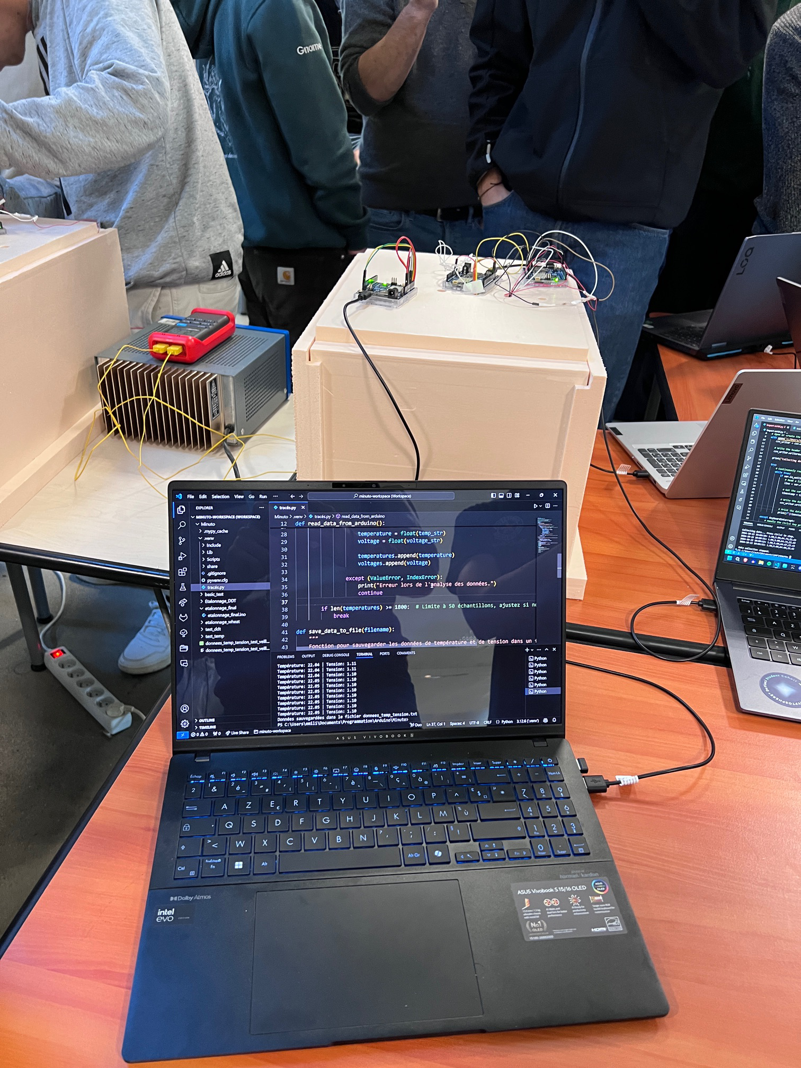
Photos/IMG_5781.JPG
