Emilien-Wolff/Minuto/Photos/IMG_5783.JPG

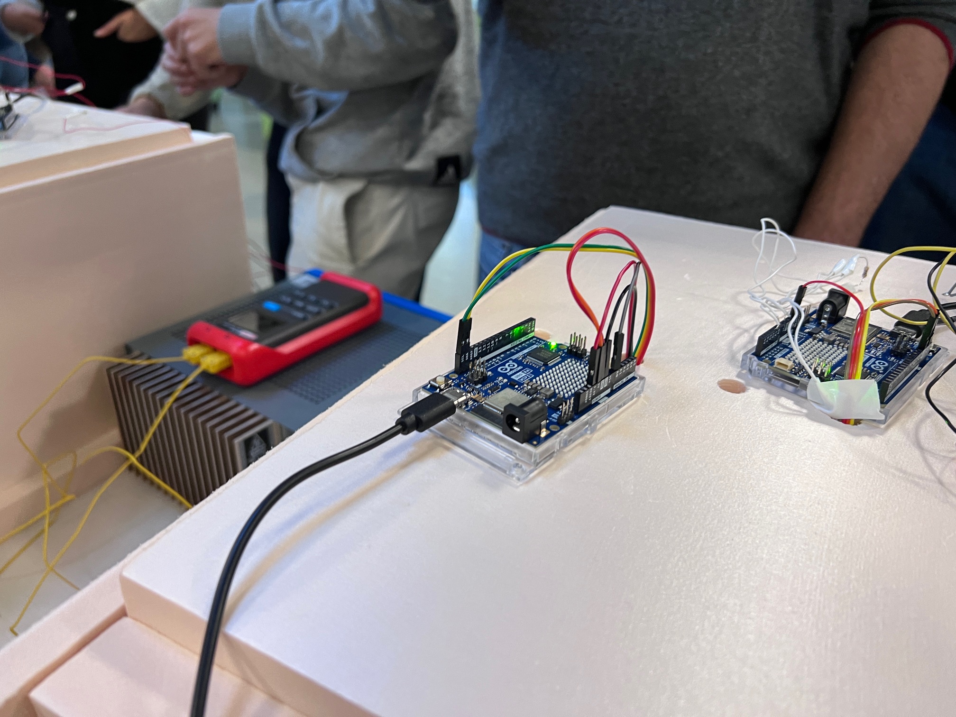
Photos/IMG_5783.JPG
