Emilien-Wolff/Minuto/Photos/IMG_6136.JPG

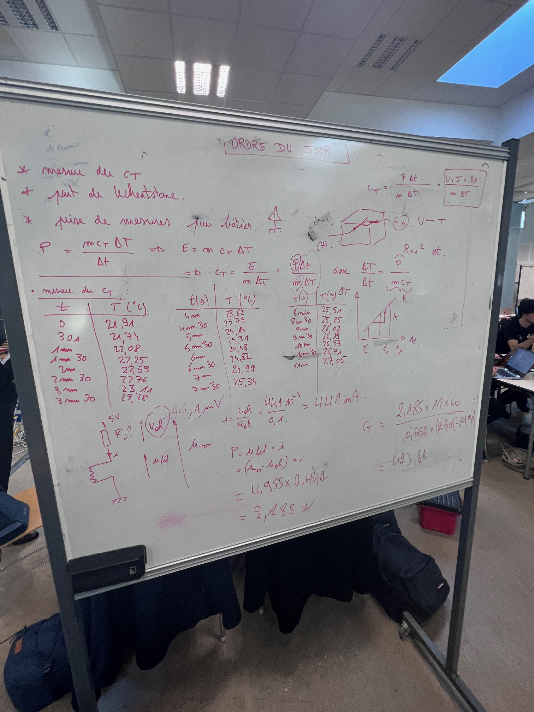
Photos/IMG_6136.JPG
