Emilien-Wolff/Minuto/Photos/IMG_6160.JPG

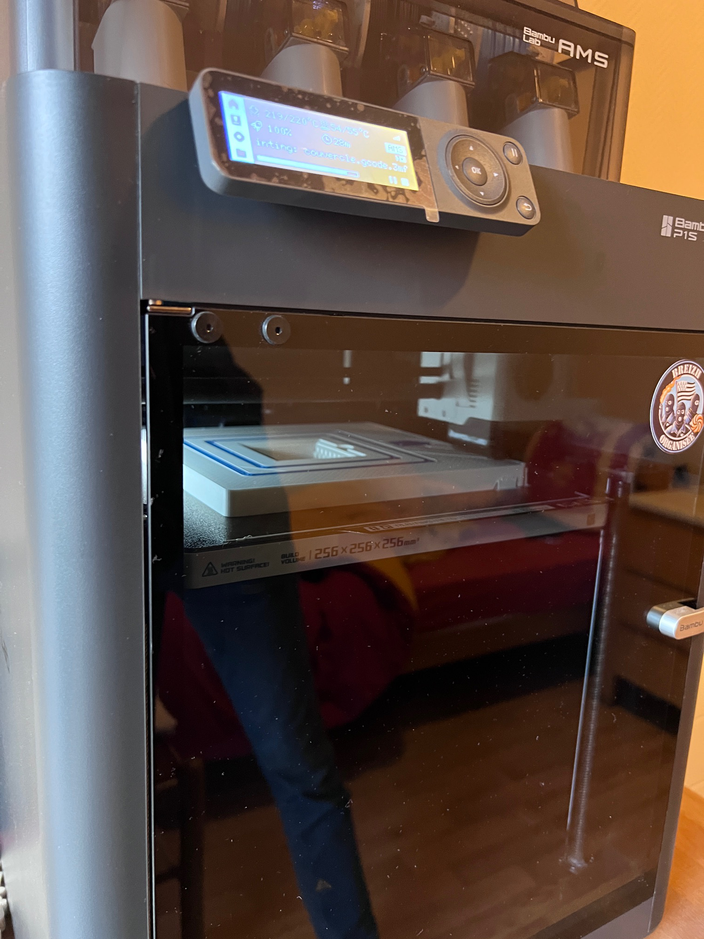
Photos/IMG_6160.JPG
