Emilien-Wolff/Minuto/Photos/IMG_6162.jpg

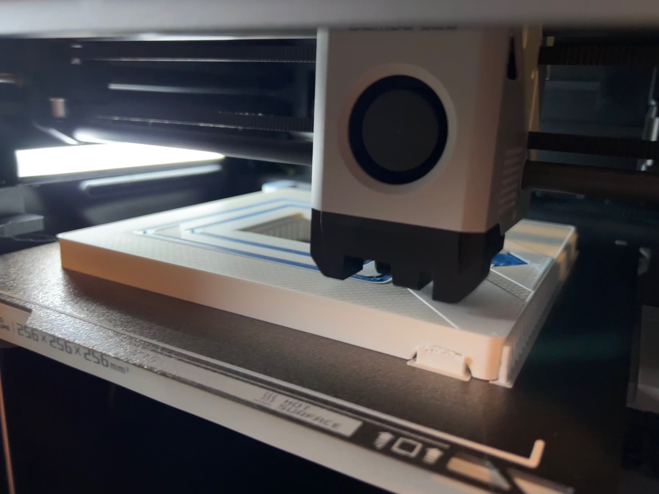
Photos/IMG_6162.jpg
