Emilien-Wolff/Minuto/Photos/IMG_6276.JPG

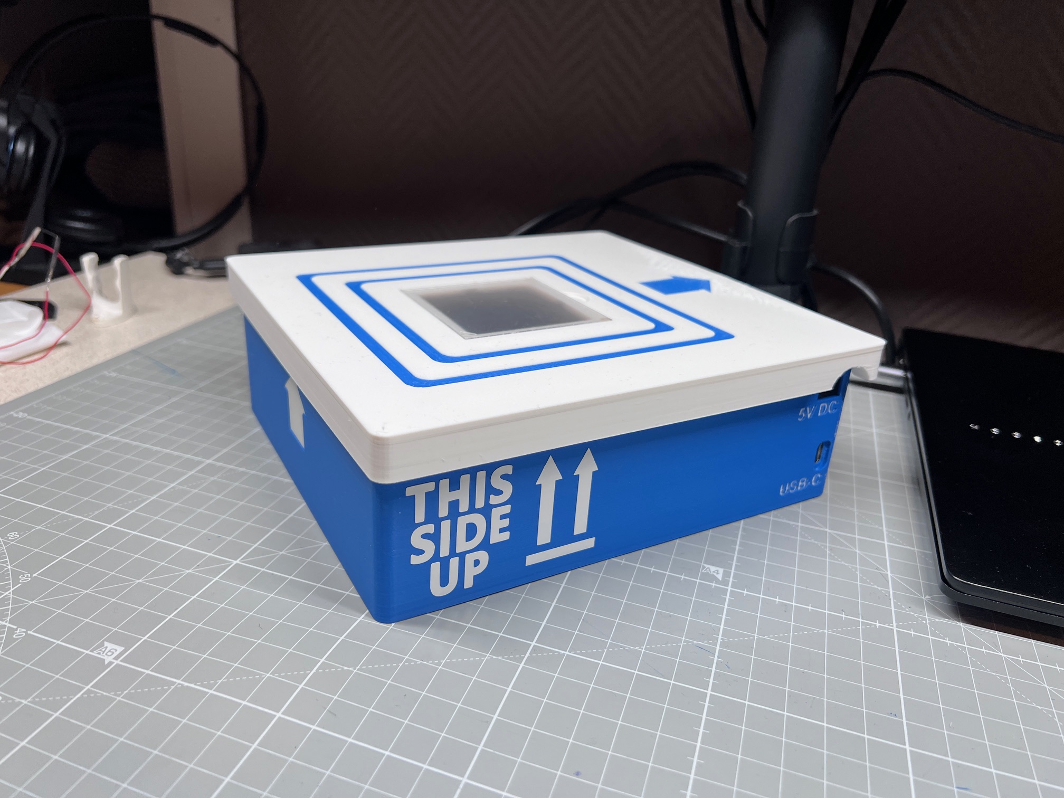
Photos/IMG_6276.JPG
