Emilien-Wolff/Minuto/Photos/IMG_6277.JPG

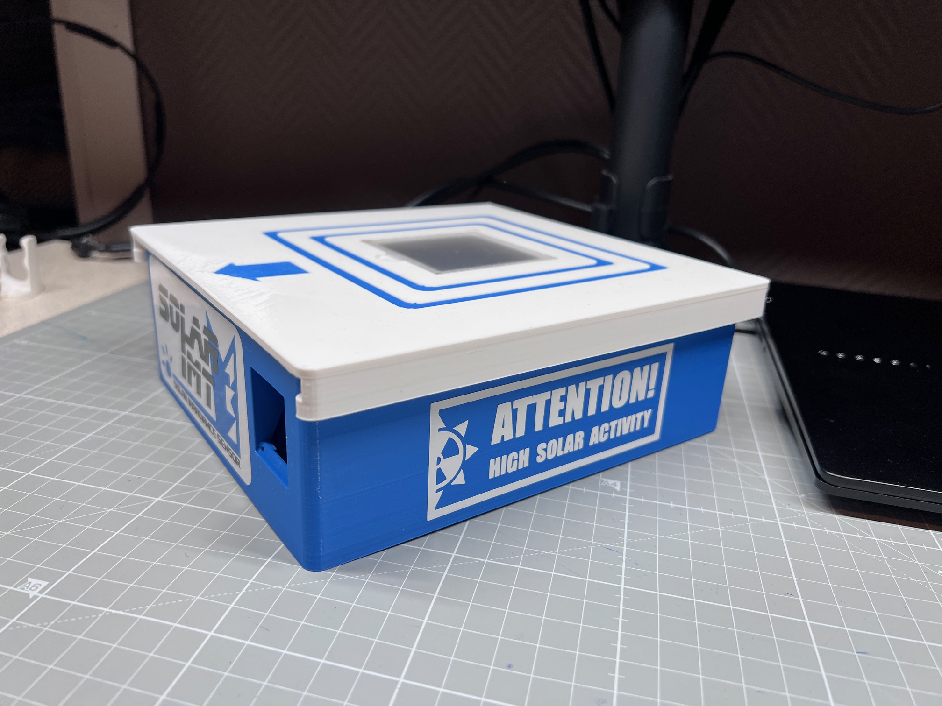
Photos/IMG_6277.JPG
