Emilien-Wolff/Minuto/Photos/IMG_6278.JPG

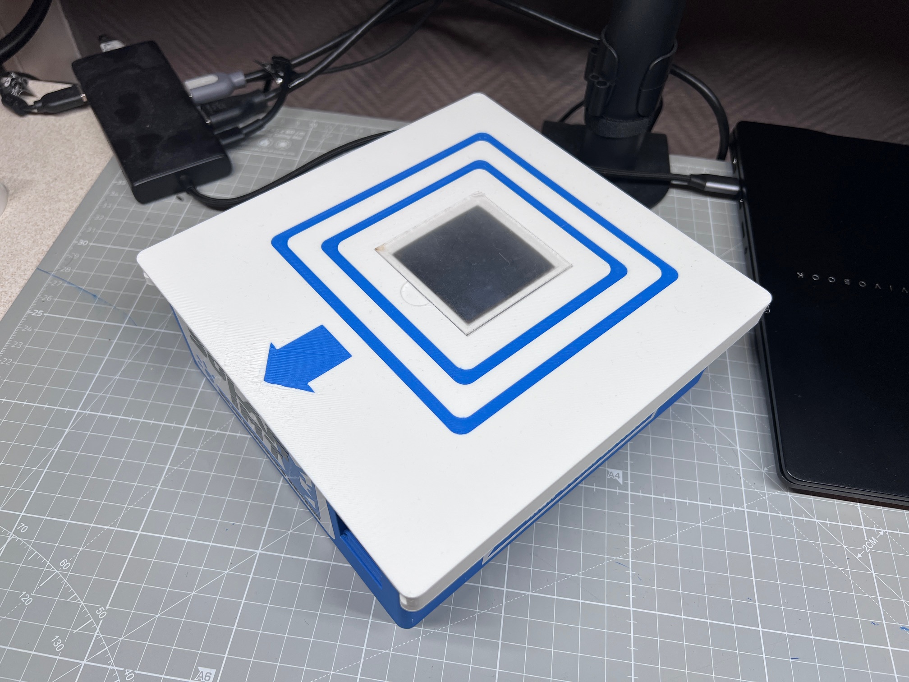
Photos/IMG_6278.JPG
