Emilien-Wolff/Minuto/Photos/IMG_7339.JPG

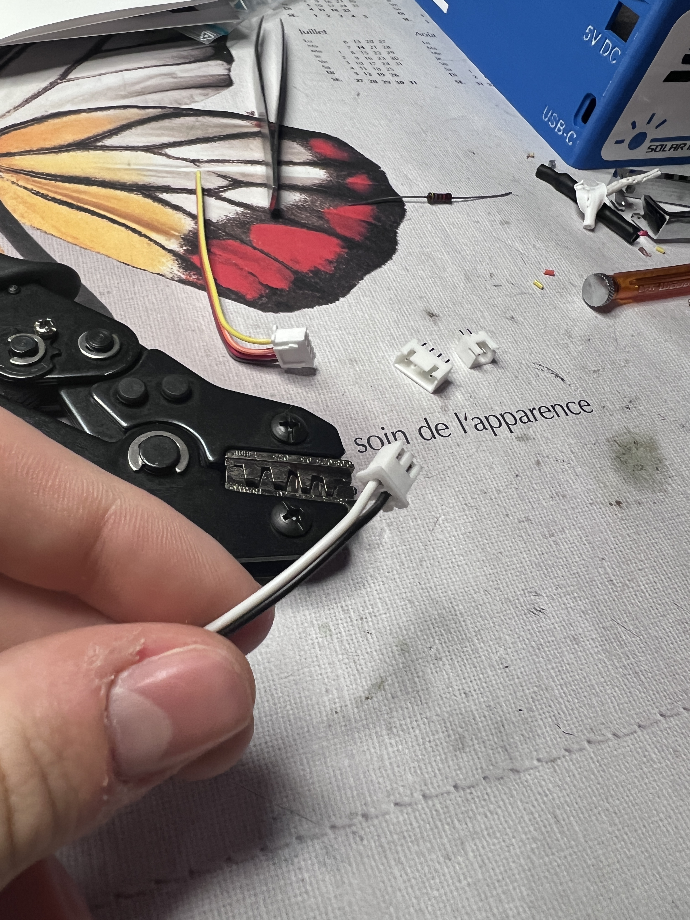
Photos/IMG_7339.JPG
