Emilien-Wolff/Minuto/PCB/Minuto_BOM.csv

ID | Name | Designator | Footprint | Quantity | Manufacturer Part | Manufacturer | Supplier | Supplier Part | Price
1 | 10uF | C1 | CAP-TH_BD4.0-P1.50-D0.8-FD | 1 | KS106M050C07RR0VH2FP0 | CX(承兴) | LCSC | C32856 | 0.013
2 | thermistance | CN2 | CONN-TH_XH-2A | 1 | XH-2A | CAX | LCSC | C722856 | 0.007
3 | XH-4AK-E | CN3 | CONN-TH_XH-4AK-E | 1 | XH-4AK | CAX(创都) | LCSC | C722871 | 0.013
4 | 100R | R1 | AXIAL-1.0 | 1 | EWWR0003J250RT9 | ResistorToday | LCSC | C348861 | 0.087
5 | Rvar | R2 | AXIAL-1.0 | 1 | EWWR0003J250RT9 | ResistorToday | LCSC | C348861 | 0.087
6 | INA125P | U1 | PDIP-16_L19.3-W6.4-P2.54-LS7.9-BL | 1 | INA125P | TI(德州仪器) | LCSC | C1346100 | 3.821
7 | 200R | U2 | RES-ADJ-TH_3P-L9.7-W5.0-P2.54 | 1 | T93YA103KT20 | VISHAY(威世) | LCSC | C3250061 | 1.992
