Emilien-Wolff/Minuto/PCB/Minuto_Schematic.pdf

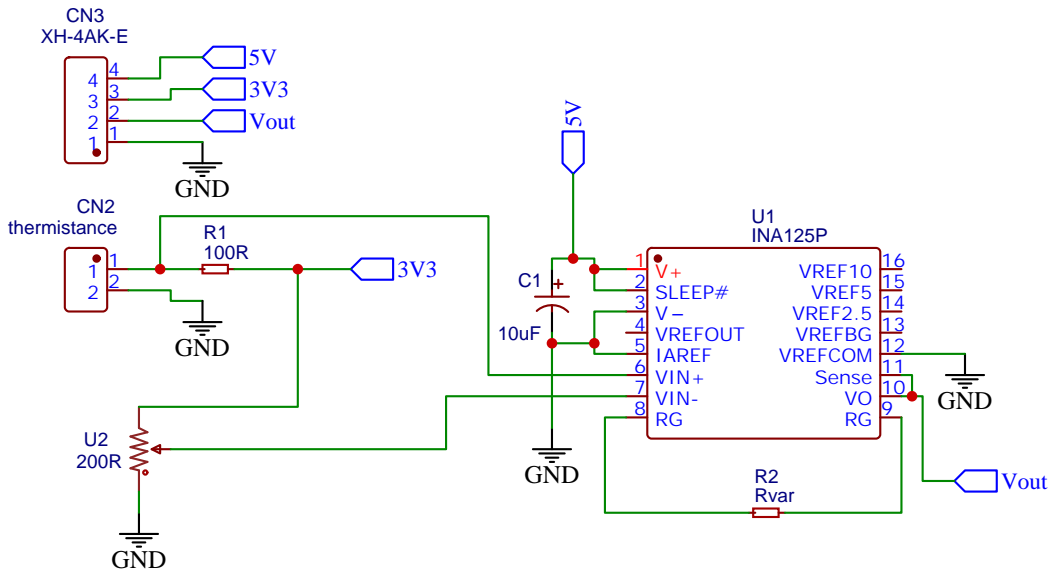
[picture p23: page 1]

Drawn By: emilien.wolff
