Emilien-Wolff/Minuto/PCB/Minuto_PCB_Composants.pdf

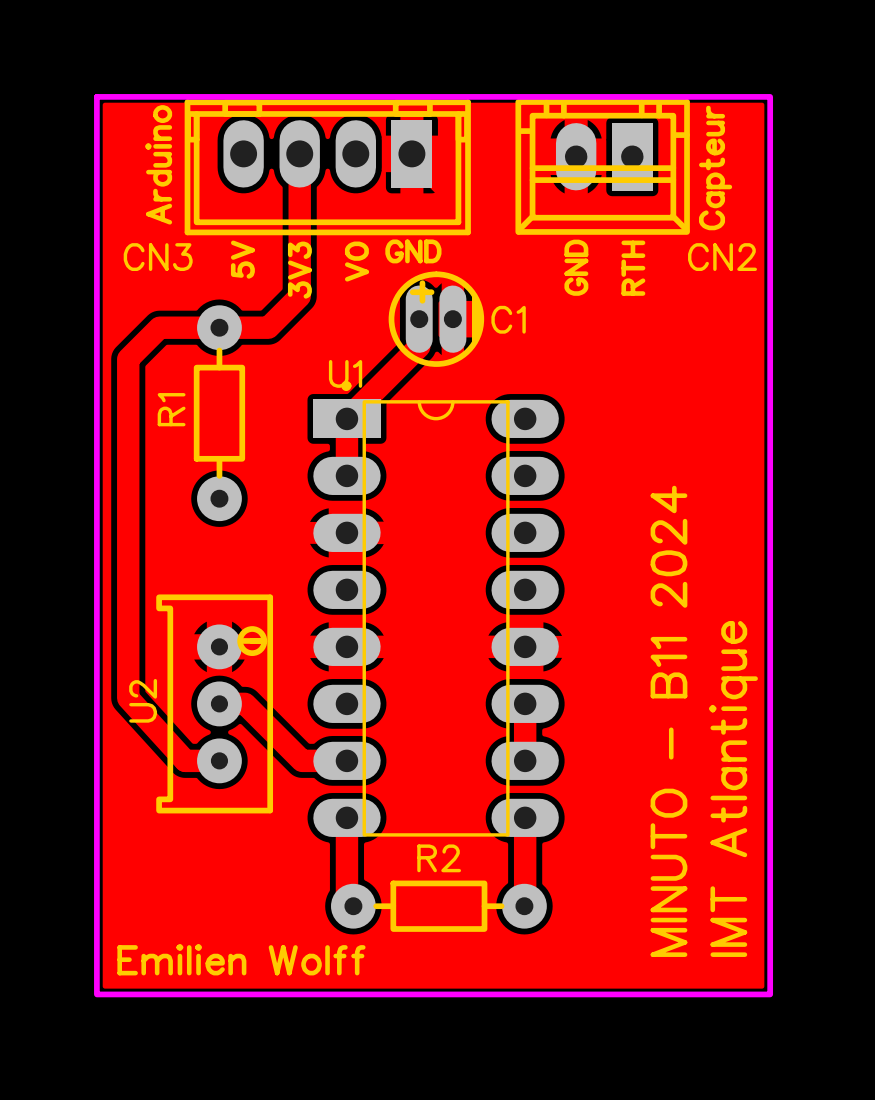
[picture p24: page 1]
