Emilien-Wolff/Minuto/PCB/Minuto_PCB_Dessous.pdf

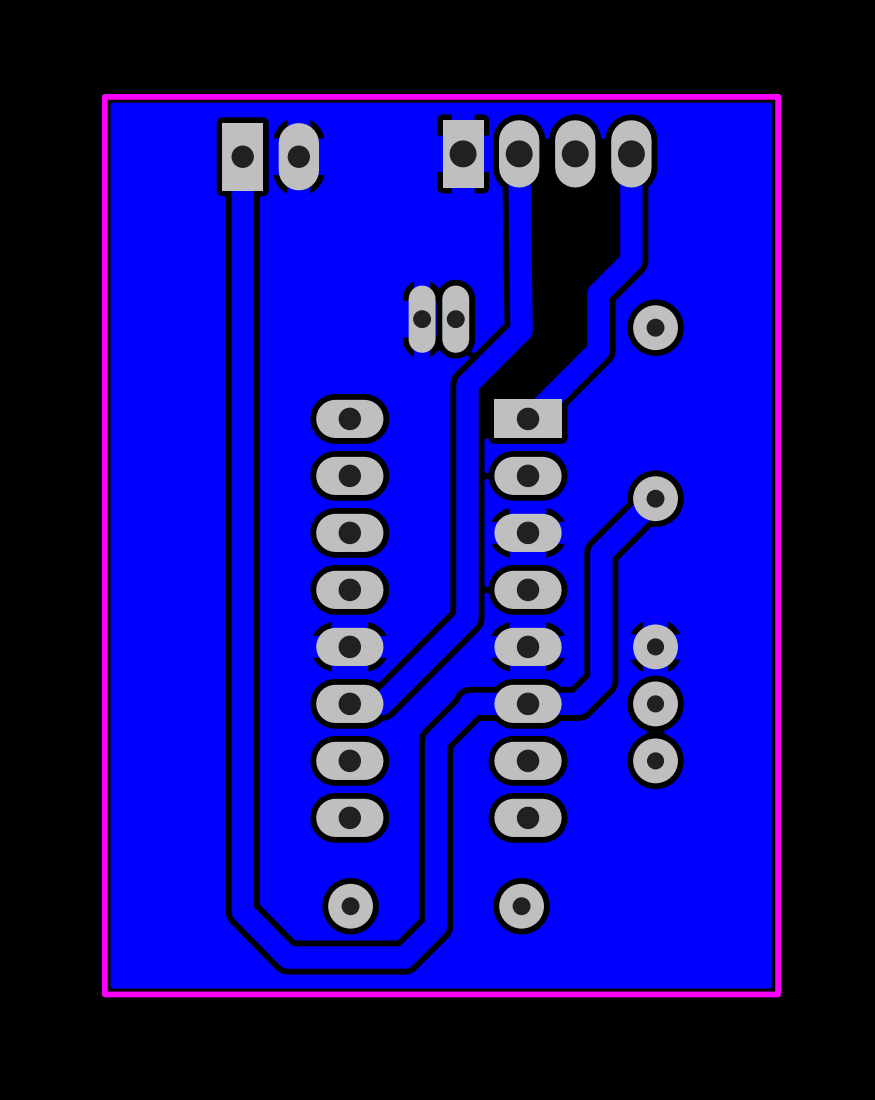
[picture p25: page 1]
