Emilien-Wolff/Minuto/(list of files, drawings)

Other design files:
PCB/MinutoEasyEdaPCB.json
PCB/MinutoEasyEdaSchematics.json
