Emilien-Wolff/Minuto/(commit log)

2025-02-23 Create Fichier gerber PCB
2025-02-23 Create Codes arduino
